Btech-project-2019/APFPOWVM/render/bottom.jpg

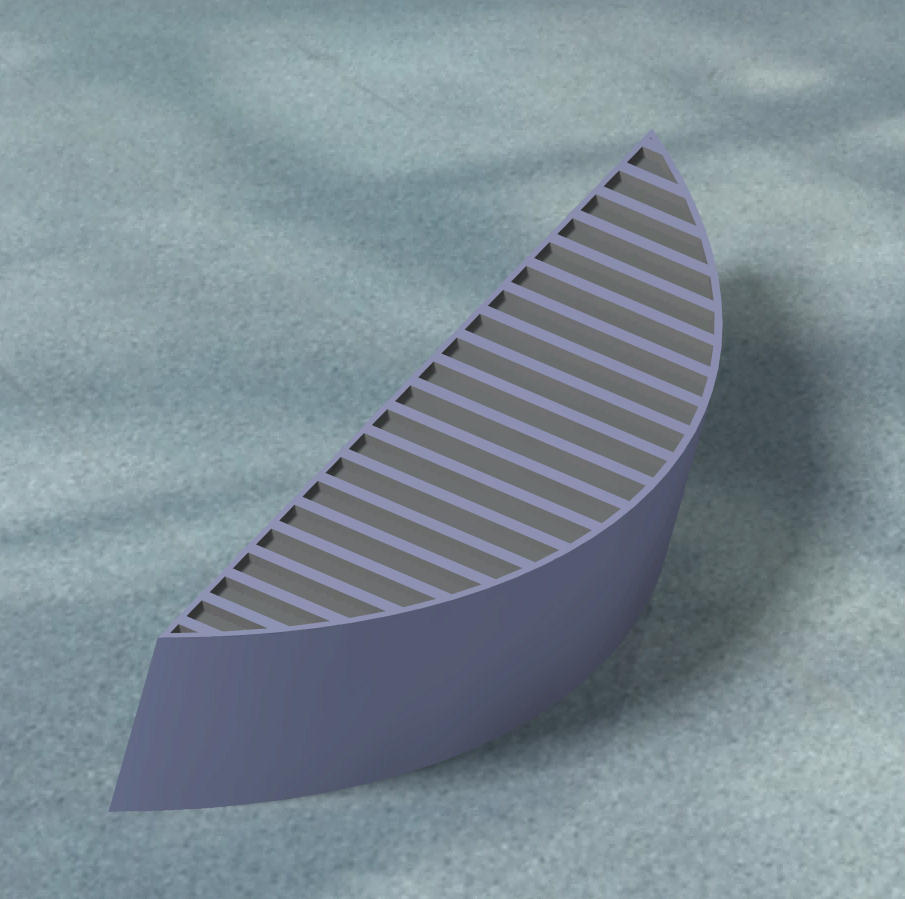
render/bottom.jpg
