Btech-project-2019/APFPOWVM/render/sevice door.jpg

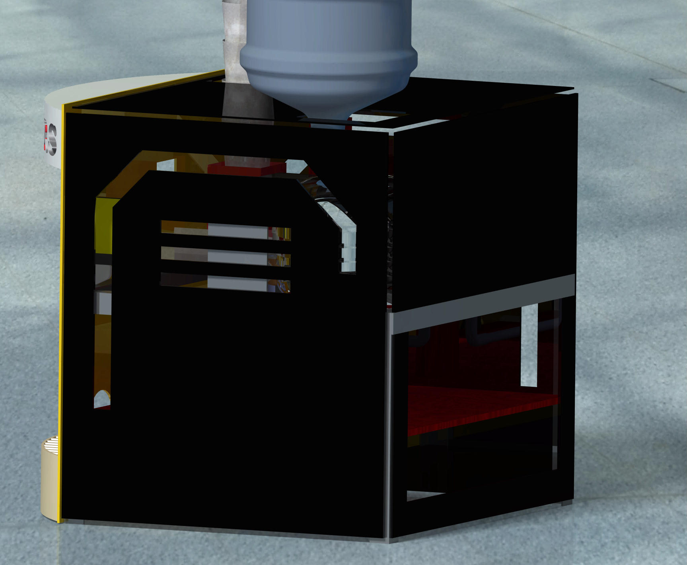
render/sevice door.jpg
