Btech-project-2019/APFPOWVM/README.md

# Automatic-paper-cup-fed-payment-operated-water-vending-machine
## [Project Report](https://github.com/btechproject2019/Automatic-paper-cup-fed-payment-operated-water-vending-machine/blob/master/pre%20project/Automatic%20vending%20Machine.pdf).
