Btech-project-2019/APFPOWVM/pre project/final presentation electronics.pptx

## Controlling System

- Flow chart:

## Slide 2

START

DISPLAY INSERT THE COIN ON LCD

COIN ACCEPTED

Dispense glass

Deciding type of water

START THE TAP FOR 10 sec

WATER DISPENSED

STOP

## Electronic Components

- Hardware:
1. Arduino Mega
2. Servo motors (10kgcm)
3. Relay for operating heater
4. WIFI Module for communication.

## Need for water level measurement

- The water level present In the smaller and larger container should be known so that flow rate of the water can be determined.
- This change in the flow rate will change the time required to fill the glass.

## Methods for measuring water level:

1. Counting amount of water dispensed.
2. Weight measurement.
3. Level Measurement.

## Counting amount of water dispensed.

- This is based on the assumption that initial volume of the water in both the containers is known.
- By knowing the water dispensed , The actual volume and head available can be found and hence the flow rate can be estimated.
- This method is completely theoretical, doesn’t need any instrumentation but depends mainly upon initial volume calculation accuracy.

## Weight measurement.

- This method includes measuring the weight of water present in the container by using load sensor and then from weight measuring the head, flow rate and then estimating time for filling the glass.
- This method requires an load cell for weight measurement but it is more accurate with easy to interpret results.

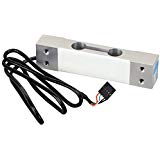
[picture p20: figure]

## Water level measurement

- Water level or head of water available can be easily found using an ultrasonic sensor.
- The ultrasonic sensor can be placed above the larger plastic container so that thickness of container comes in blind range of the sensor and it can give water level present in the container.
- But these results are subjected to error due to presence of the plastic wall in blind range of sensor.

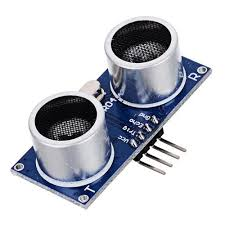
[picture p21: figure]

## Internet of things :

- The IOT is used for making the water dispenser smart.
- This is done by establishing the communication between water dispenser and another device connected to internet like a smartphone.
- By establishing the communication, these two devices can exchange information like water level, No of normal and hot water glasses dispensed in a day.

## IOT Block Diagram

Internet

Dispenser Controller

Smart
Phone

WiFi
ESP
8266
