Btech-project-2019/APFPOWVM/final internal.pptx

## Automatic Paper Glass Fed Liquid Dispensing Machine

Prateek Shamprasad Pawar 2015BME002
Prasad Shamrao Deshpande 2015BME016
Bhagwan Panditrao Savandkar 2015BME017
Niranjan Mohan Mane 2015BME032
Manthan Nitin Dhisale 2015BME051
Under the Guidance of
Prof. P.B.Chougule

## MANUFACTURING

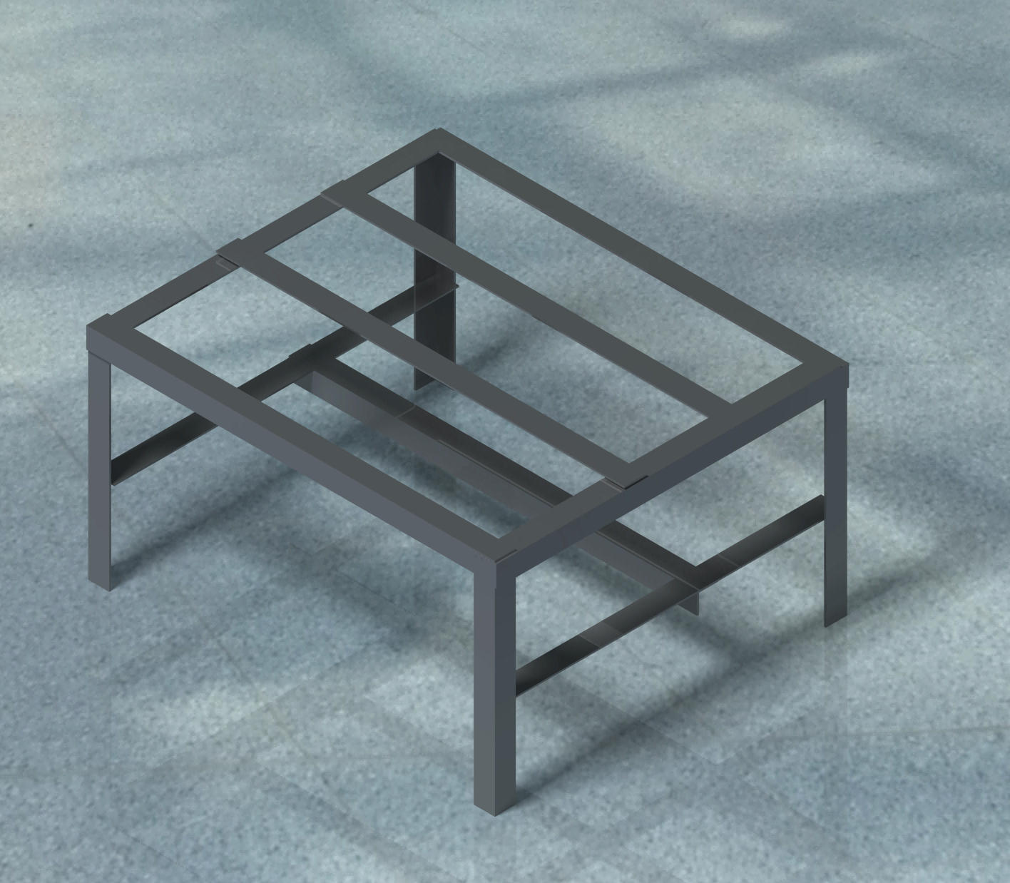
[picture p24: figure]
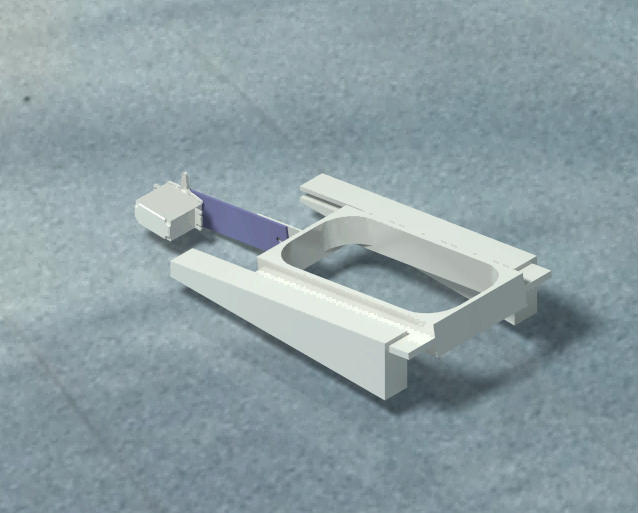
[picture p25: figure]
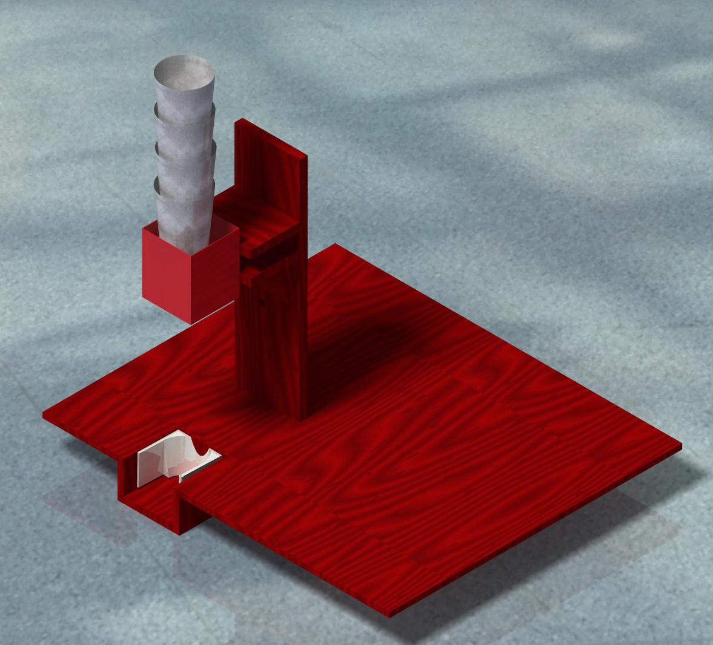
[picture p26: figure]
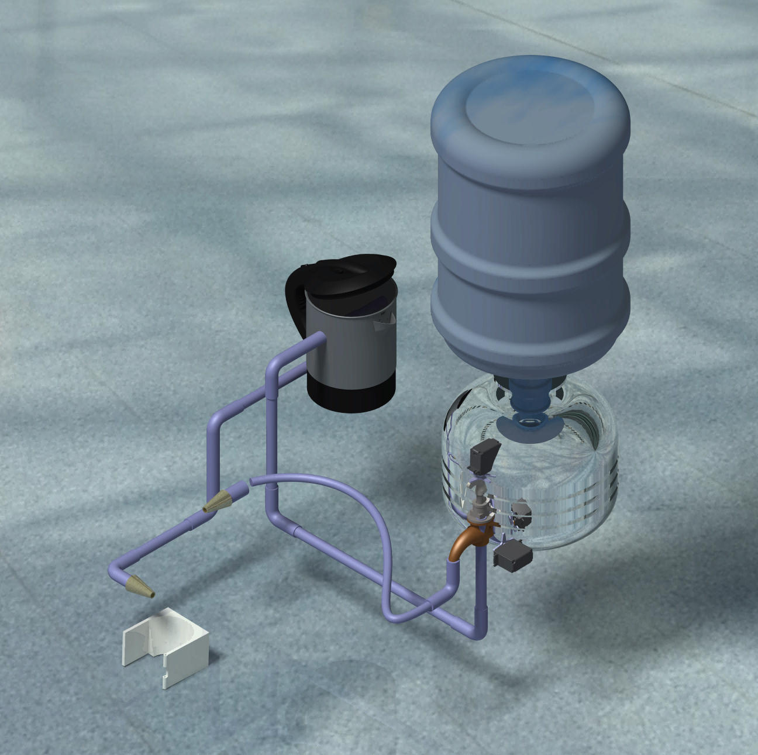
[picture p27: figure]
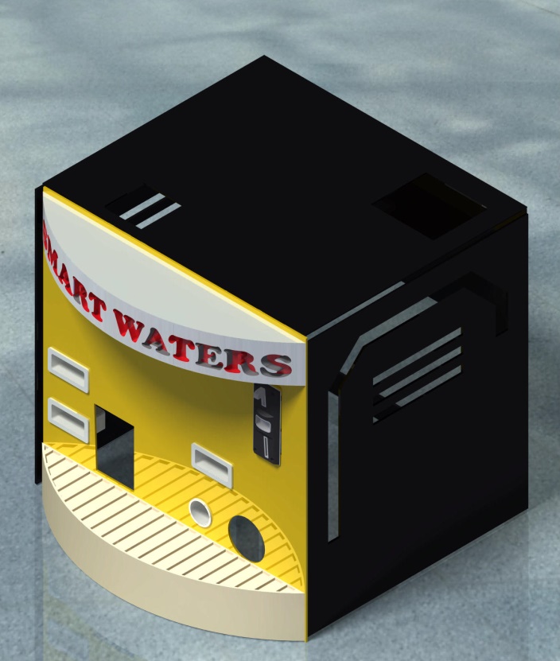
[picture p28: figure]

3. GLASS STACK

5. PANELS

4. WATER CKT

2. SLIDER & CUP CATCHER

1. TRUSS

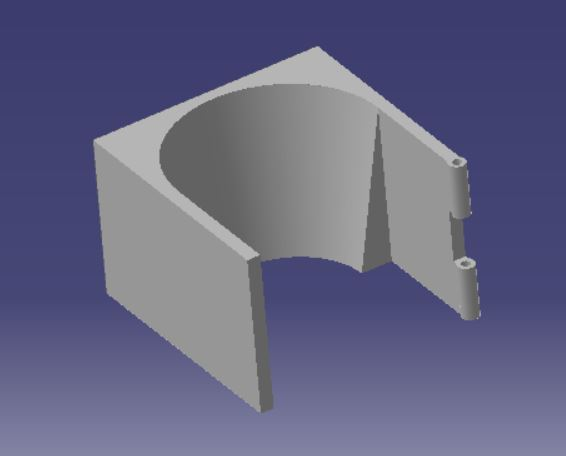
[picture p29: figure]

## PROCESS PLANNING

- Welding Truss
- Sheet Metal Forming Sink
- 3D Printing Cup Catcher and Slider Mechanism
- Bolting Panels and electronic components
- CNC Router Cutting Panels
- End Milling Heater Inlet and Outlet
- Radial Drilling and reaming Dispenser, Glass stack stand
- Adhesive Bonding Plumbing PVC pipes and Bibcocks
- Cutting, Grinding Truss, Cup guider, acrylic, etc
- Soldering Wires from wifi module, Arduino, Relay, SMPS etc to the supply

## DESIGN for SERVICING

Top Slider

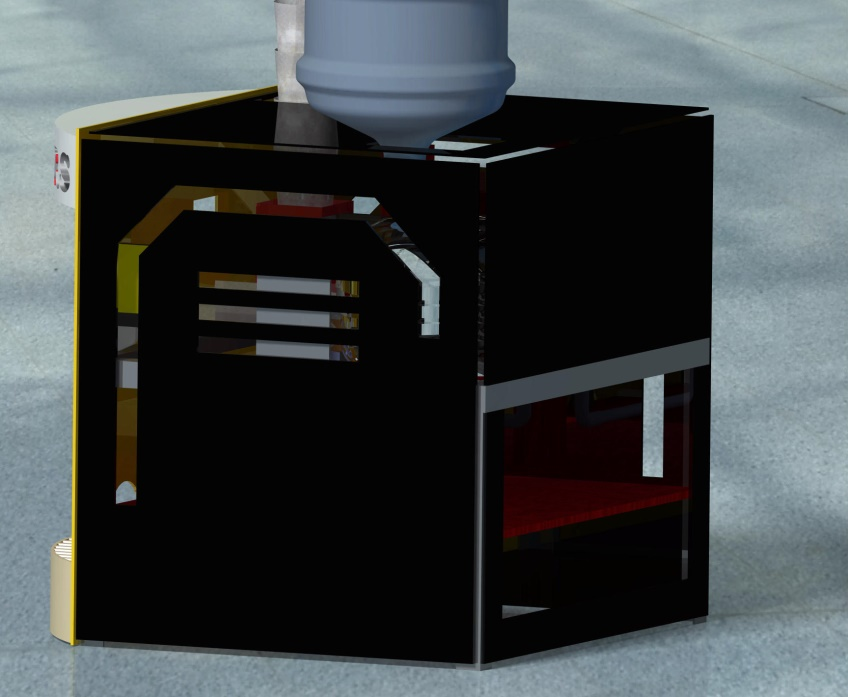
[picture p30: figure]

A. Back Door
1. Easy access to remove thrown glass
2. To collect coins entered
3. To access the electronic ckt

B. Top Slider
1. Easy access to critical parts such as coin detector
2. Water Bottle (Dispeneser) and Glass stack easy repair

Service Door
at back

## AESTHETIC

- Slots along with vents in Panels Consist of
Aluminium Composite Polymer (ACP) Sheets
- Arc Shaped Smart Waters
- Water Sink in shape of Rib

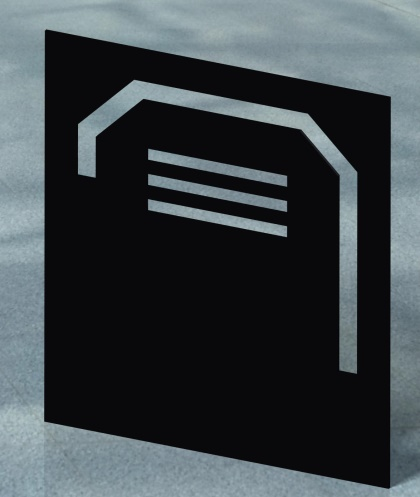
[picture p31: figure]
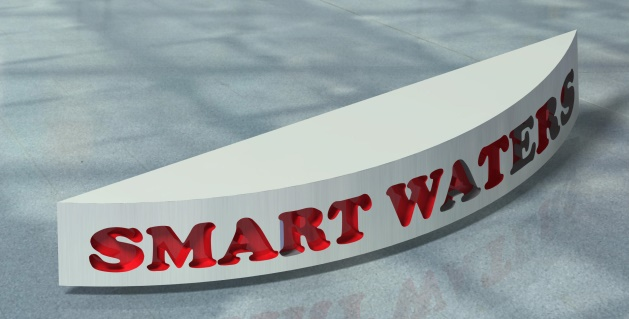
[picture p32: figure]
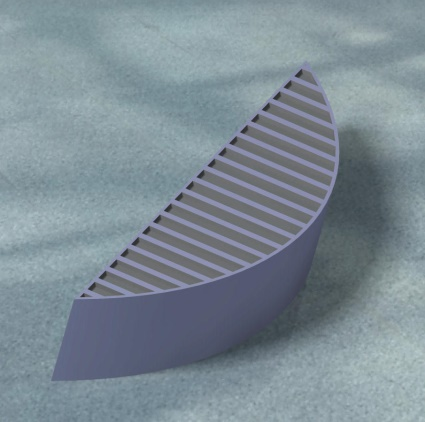
[picture p33: figure]

## ERGONOMICS

## FINANCE

## USP

## THANK YOU
