Btech-project-2019/APFPOWVM/pre project/water vending.pptx

## Payment Operated Automatic Paper Glass Fed Liquid Dispensing Machine

- Prateek Shamprasad Pawar(2015BME002)
- Prasad Shamrao Deshpande(2015BME016)
- Bhagwan Panditrao Savandkar(2015BME017)
- Niranjan Mohan Mane(2015BME032)
- Manthan Nitin Dhisale(2015BME051)

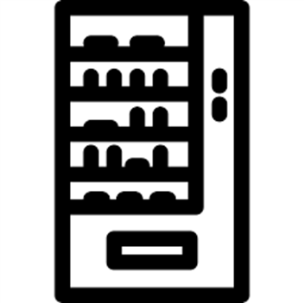
[picture p34: figure]
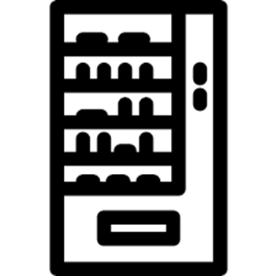
[picture p35: figure]
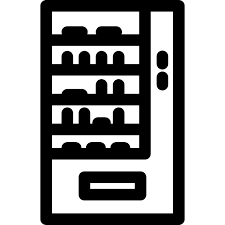
[picture p36: figure]
Image result for vending machine logo

## Planning

Forecasting
Setting Premises
Setting Objectives

## Forecasting

1. 70% of body is made of water

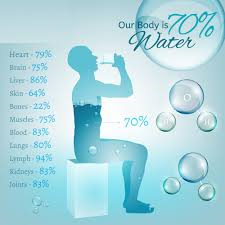
[picture p37: figure]

## Forecasting

2. Usage of water not optimal, wastage

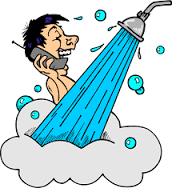
[picture p38: figure]

## Forecasting

3. Government of Maharashtra bans non-biodegradable plastics, threat to packaged drinking water

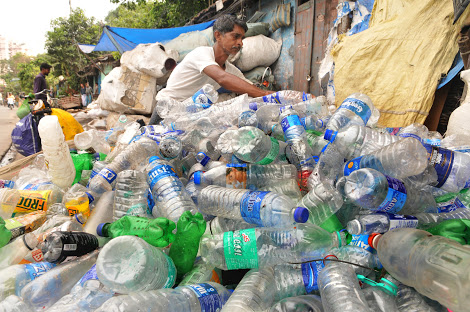
[picture p39: figure]

## Forecasting

4. Government launched Swatcha Jal Abhiyan

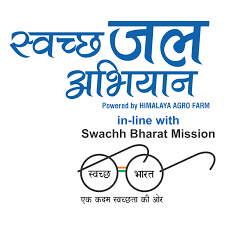
[picture p40: figure]

## Forecasting

5. Current water distribution system, too many intermediates, waste of money and time

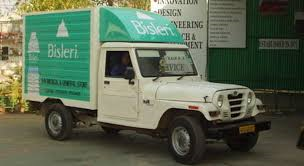
[picture p41: figure]

## Forecasting

6. iOT based SCM is growing need of time and era of vending machines (self pay and purchase) is about to begin.

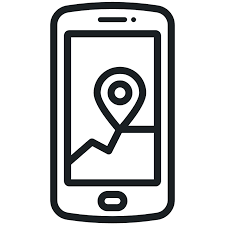
[picture p42: figure]
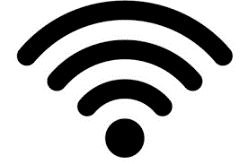
[picture p43: figure]

## Setting Premises

- Considering a rough model of our Sangli city and knowing stats about how much glasses of water will be required and how many visitors will be present, we came up with optimized setup.

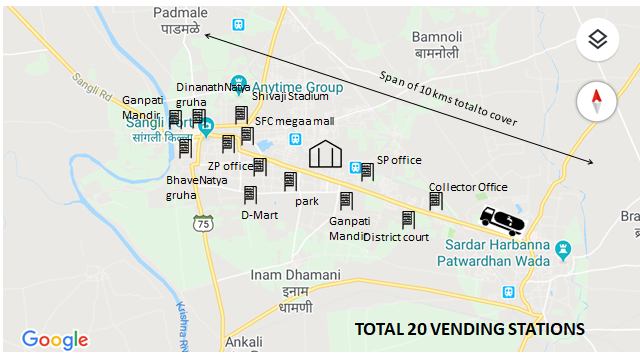
[picture p44: figure]

## Visions and objectives

1. To study different mechanical and electronic principles involved in the automation project.
2. To select appropriate sensors and actuators for constructing various mechanisms involved in the automation project. 3.
3. To manufacture a complete workable and commercial model by following aesthetic and ergonomic principles.
4. To implement Information of technology principles for exchange of information from the dispenser to the user.
5. To execute a proper algorithm-based program for Arduino controlled sensors and actuators for the intended application.
6. To include liquid monitoring features so as to control and provide proper dispensing of liquid to the customer.

## Implementation

- The implementation of the project plan is an important step because the accuracy of plan made for project is depending upon actual time taken for activity.

## Slide 12

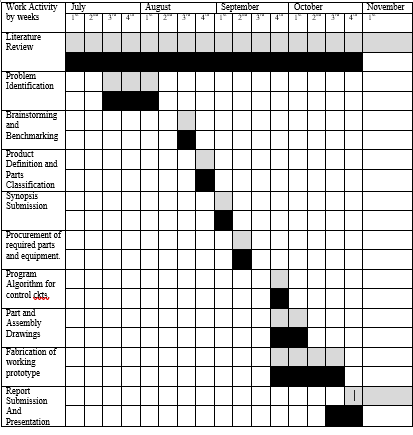
[picture p45: figure]
