Btech-project-2019/APFPOWVM/flow chart.pdf

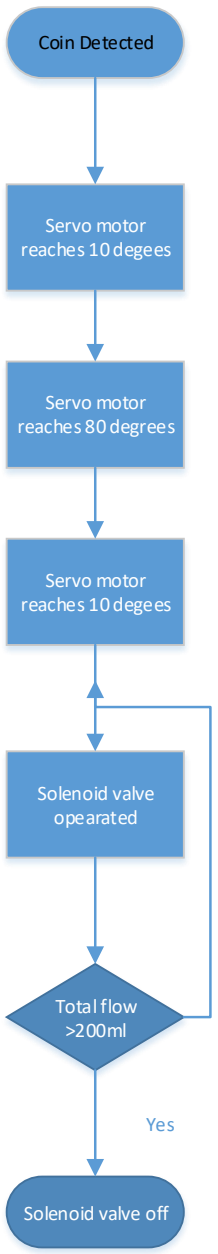
[picture p46: figure]
Coin Detected; Servo motor reaches 10 degees; Servo motor reaches 80 degrees; Solenoid valve opearated; Total flow >200ml; Solenoid valve off; Yes

NO
