Btech-project-2019/APFPOWVM/report/introduction.docx

History Of Vending Machine-

"Vending" or "automatic retailing" or Dispensing Machine as the process of selling merchandise via automated machine is increasingly known, has a long history. The first recorded example of a vending machine comes from the Greek mathematician Hero of Alexandria, who invented a device that dispensed holy water inside Egyptian temples.

Other early examples include small machines made of brass that dispensed tobacco, which were found in some taverns in England around 1615. In 1822, an English publisher owner named Richard Carlile built a newspaper dispensing machine that allowed patrons to purchase banned works. And it was in 1867 that the first fully automatic vending machine, which dispensed stamps, appeared.

### Coin-Operated Vending Machines

During the early 1880s, the first commercial coin-operated vending machines were introduced in London, England. Invented in 1883 by Percival Everitt, the machines were found at railway stations and post offices, as they were a convenient way to purchase envelopes, postcards, and notepaper. And in 1887, the first vending machine servicer, the Sweetmeat Automatic Delivery Company, was founded.

In 1888, the Thomas Adams Gum Company introduced the very first vending machines to the United States. The machines were installed on the elevated subway platforms in New York City and sold Tutti-Fruiti gum. In 1897, the Pulver Manufacturing Company added animated figures to its gum machines as an added attraction. The round, candy-coated gumball (https://www.thoughtco.com/history-of-bubble-and-chewing-gum-1991856) and gumball vending machines were introduced in 1907.

### Coin-Operated Restaurants

Soon, vending machines were available that offered almost everything, including cigars, postcards, and stamps. In Philadelphia, a completely coin-operated automat (https://www.thoughtco.com/the-rise-and-fall-of-the-automat-4152992) restaurant called Horn & Hardart was opened in 1902 and stayed opened until 1962. Such fast-food restaurants, called automats, only took nickels and were popular among struggling songwriters and actors, as well as celebrities of that era.

### Beverage Vending Machines

Machines that dispensed drinks go as far back as 1890. The very first beverage vending machine was located in Paris, France and allowed people to buy beer wine and liquor. In the early 1920s, the first automatic vending machines started dispensing sodas (https://www.thoughtco.com/introduction-to-soda-pop-1992433) into cups. Today, beverages are among the most popular items sold through vending machines.

### Cigarettes in Vending Machines

In 1926, an American inventor named William Rowe invented the cigarette (https://www.thoughtco.com/who-invented-electronic-cigarettes-1991598) vending machine. Over time, however, they became increasingly less common in the United States due to concerns over underage buyers. In other countries, vendors have addressed the issue by requiring that some sort of age verification, such as a driver's license, bank card or ID be inserted before a purchase can be made. Cigarette dispensing machines are still common in Germany, Austria, Italy, the Czech Republic, and Japan.

### Specialty Vending Machines

Food, beverages, and cigarettes are the most common items sold in vending machines, but the list of specialty items sold by this form of automation is almost endless, as a quick survey of any airport or bus terminal will tell you. The vending machine industry took a big jump around 2006, when credit card scanners started to become common on vending machines. Within ten years, almost every new vending machine was equipped to accept credit cards. This opened the door to the sale of many high-priced items through vending machines. Here are just some of the specialty products that have been offered via vending machine:

- Fishing bait
- On-line internet time
- Lottery tickets
- Books
- Electronics, including I-pads, cell phones, digital cameras, and computers.
- Hot foods, such as french fries and pizza
- Life insurance
- Condoms and other contraceptives
- Over-the-counter drugs
- Marijuana
- Automobiles

Yes, you read that last item correctly. In late 2016, Autobahn Motors in Singapore opened a luxury car vending machine that offered Ferrari and Lamborghini cars. Buyers clearly need hefty limits on their credit cards.

### Japan, Land of the Vending Machines

Japan has gained a reputation for having some of the most innovative use of vending machines, offering machines that offer products including fresh fruits and vegetables, sake, hot foods, batteries, flowers, clothing and, of course, sushi. In fact, Japan has the highest per capita rate of vending machines in the world.

Popularity in Japan-

Vending machines are a common sight in Japan. There are more than 5.5 million throughout the nation. It is the highest ratio for any country with one machine for every twenty-three people.

## Smart vending machines

Similar to the development of traditional mobile phones (https://en.wikipedia.org/wiki/Mobile_phones) into smartphones (https://en.wikipedia.org/wiki/Smartphones), vending machines have also progressively, though at a much slower pace, evolved into smart vending machines. Newer technologies at a lower cost of adoption, such as the large digital touch display (https://en.wikipedia.org/wiki/Touchscreen), internet connectivity, cameras and various types of sensors, more cost-effective embedded computing (https://en.wikipedia.org/wiki/Embedded_computing) power, digital signage (https://en.wikipedia.org/wiki/Digital_signage), various advanced payment systems, and a wide range of identification technology (NFC (https://en.wikipedia.org/wiki/Near_field_communication), RFID (https://en.wikipedia.org/wiki/Radio-frequency_identification), etc) have contributed to this development. These smart vending machines enable a more interactive user experience, and reduce operating costs while improving the efficiency of the vending operations through remote manageability and intelligent back-end analytic (https://en.wikipedia.org/wiki/Analytics). Integrated sensors and cameras also represent a source of such data as customer demographics, purchase trends, and other locality-specific information. It also enables better customer-engagement for the brands through interactive multimedia and social media connectivity. Smart vending machines were #79 by JWT Intelligence on its list of 100 Things to Watch in 2014. According to market research by Frost & Sullivan, global shipments of smart vending machines are forecasted to reach around 2 million units by 2018, and further to 3.6 million units by 2020 with penetration rate of 20.3 percent.

Need for water dispensing unit in Indian Scenario-

In hot sunny day or in general while moving on roads, doing rigorous exercise, anywhere the thing required by everyone is water to quench thirst. Low Water level in the body leads to dehydration and which is very lethal to the life.

Ensuring clean drinking water from a trusted water source such as an RO water purifier or water filtered through RO + UV technique or water stored from above sources is what the time demands and one cannot compromise in its purity. So the proposed project will serve as a platform for payment based paper glass fed water dispensing machine, which will be storing safe and clean water from government facilities or commercial pure water suppliers.

With a vending machine, we need not to hire an employee for serving water. Neither we have to be present all the day and in night also it will provide service, as a machine it will be free from fatigue which is the behaviour of normal employee. All we need to do is to stock of water, Paper glass and electricity source for the machine and it’s done. It has features that allows the customer to purchase and pay without being assisted by anyone.

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

This is a product which will be the connecting link between government organisations and individuals or NGOs or companies to have such water distribution system which will aid in public welfare. Even companies can install such machines leading to reduced supply chain costs incurred presently and also to reduce overall cost as product is directly supplied to the end user. Even this system can be utilized for other beverages by proper changes.

This is the age of technology and ours is a sincere effort to develop an environment friendly affordable water vending facility.
