Btech-project-2019/APFPOWVM/flow_sensor/I2C-LCD-Module-Board-Arduino-Mega-2560.jpg

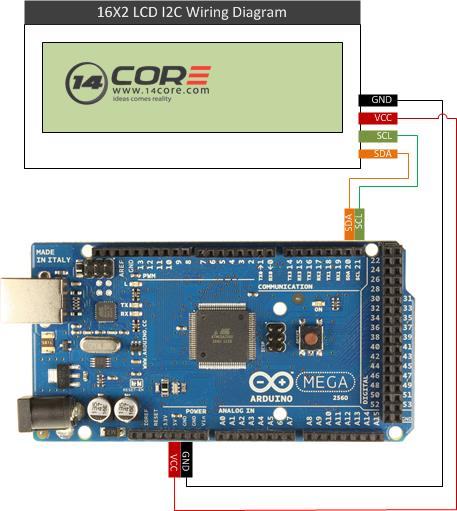
flow_sensor/I2C-LCD-Module-Board-Arduino-Mega-2560.jpg
