Btech-project-2019/APFPOWVM/pcb desigh/pcb.png

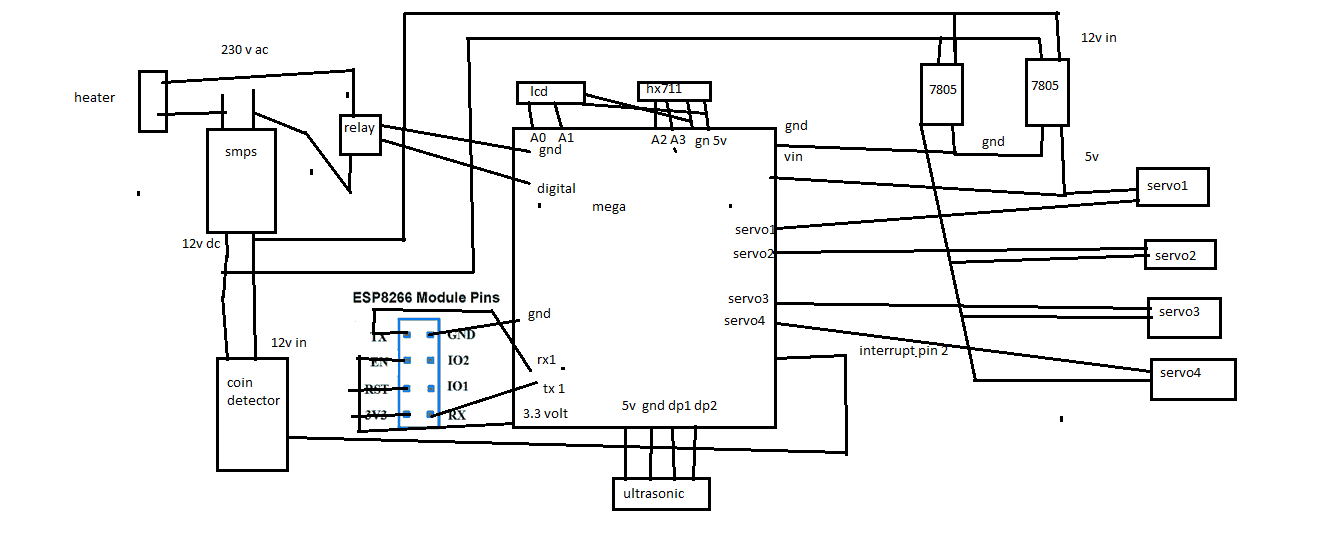
pcb desigh/pcb.png
