Btech-project-2019/APFPOWVM/project presentation/arduino.jpg

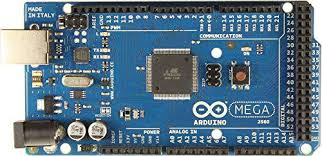
project presentation/arduino.jpg
