Btech-project-2019/APFPOWVM/project presentation/esp.jpg

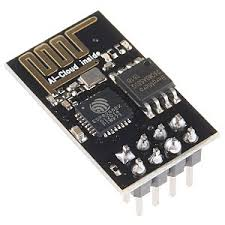
project presentation/esp.jpg
