Btech-project-2019/APFPOWVM/project presentation/telegram.jpg

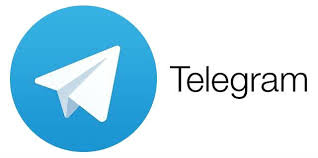
project presentation/telegram.jpg
