Btech-project-2019/APFPOWVM/project presentation/water height.bmp

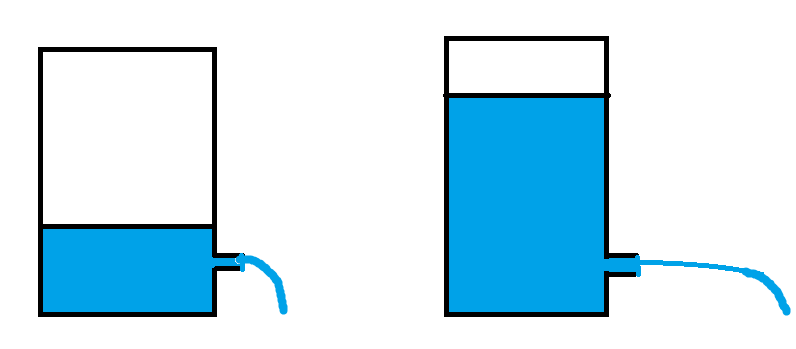
project presentation/water height.bmp
