Btech-project-2019/APFPOWVM/single-wall-cold-drink-cup-dimensions-pp.png

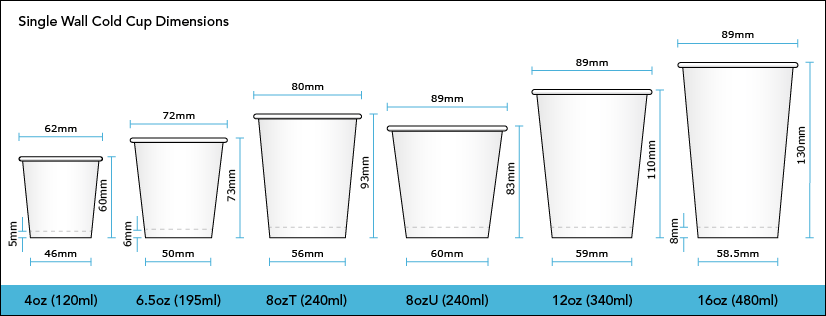
single-wall-cold-drink-cup-dimensions-pp.png
