Btech-project-2019/APFPOWVM/telegram/wifitoarduino_jz26ak1QwK.jpg

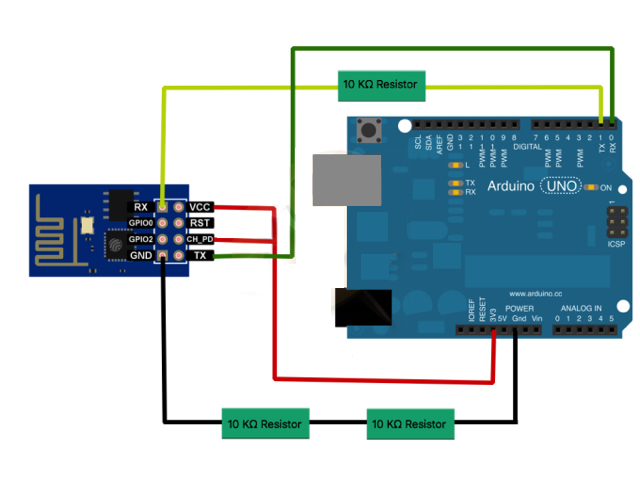
telegram/wifitoarduino_jz26ak1QwK.jpg
