Btech-project-2019/APFPOWVM/assembly final iges/cup catcher v5.SLDASM

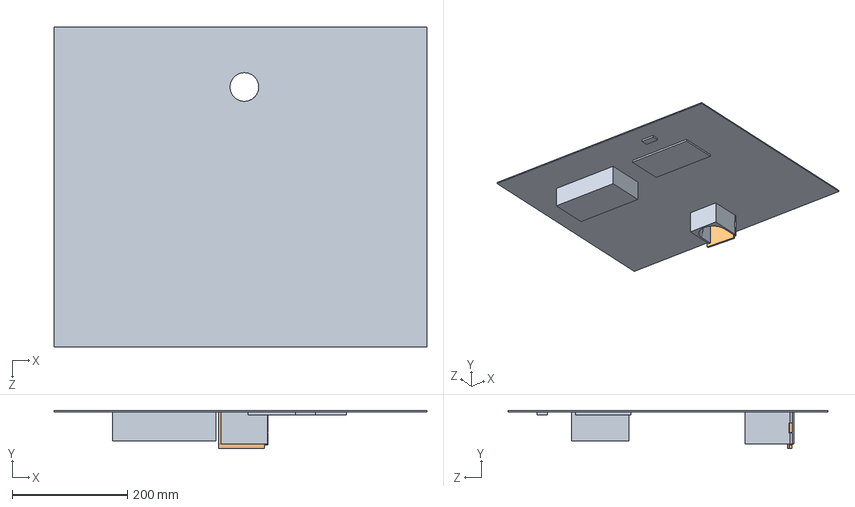
[picture p55: CAD file, 2020-05-20]
assembly final iges/cup catcher v5.SLDASM
648.4 x 66.3 x 556.5 mm
cup catcher v5
