Btech-project-2019/APFPOWVM/assembly.SLDASM

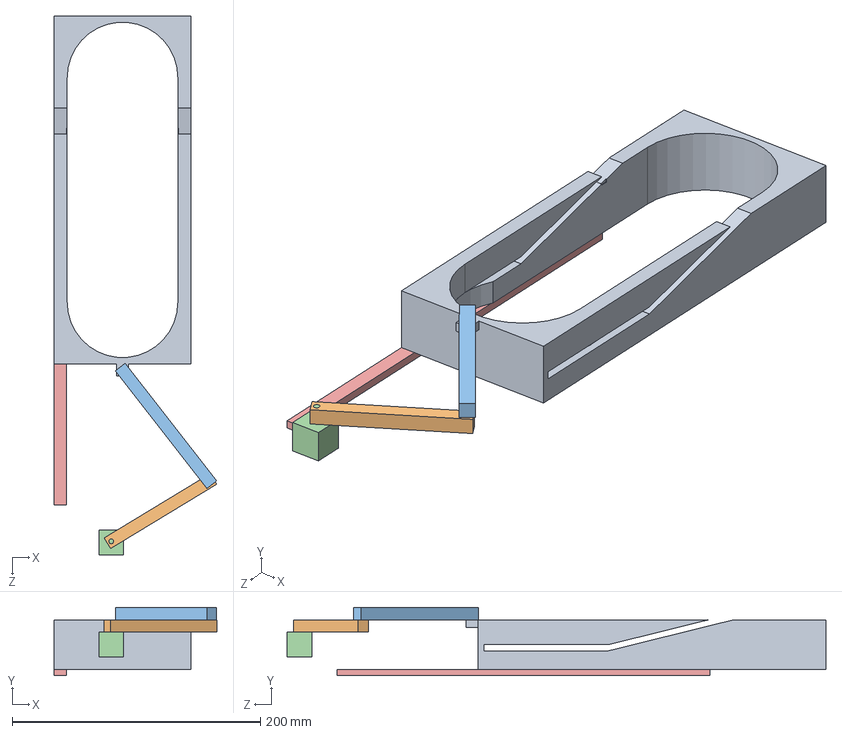
[picture p56: CAD file, 2020-05-20]
assembly.SLDASM
130.9 x 55.0 x 433.9 mm
cup separator
link 2
link1
motor
slide
