Btech-project-2019/APFPOWVM/assembly final iges/Assem1.SLDASM

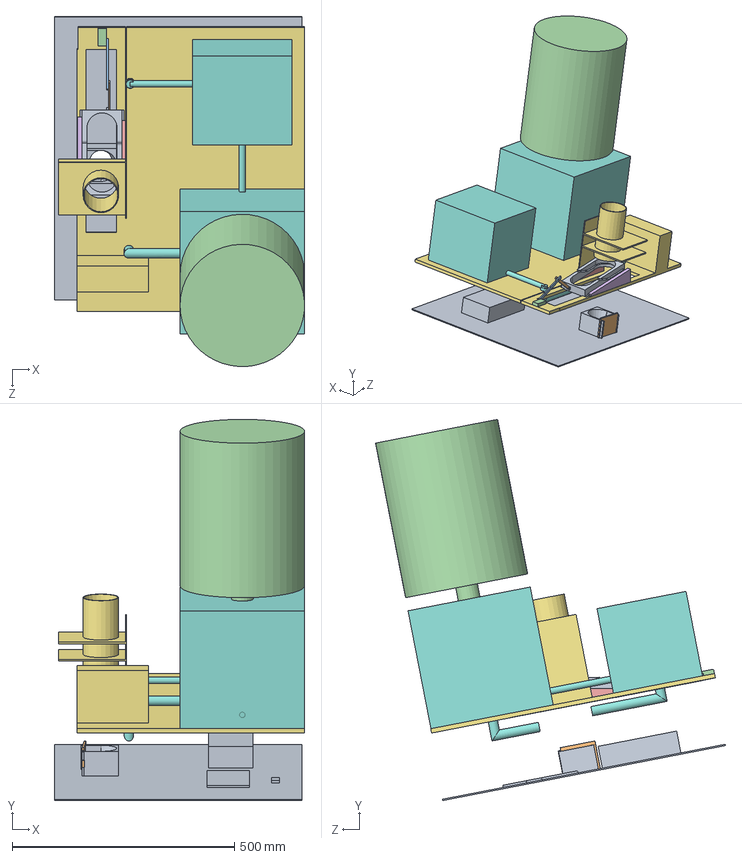
[picture p57: CAD file, 2020-05-20]
assembly final iges/Assem1.SLDASM
562.5 x 857.2 x 787.0 mm
cup separator 2
link1
link2
motor
slider1
slider2
base1
container1
cup catcher v5
container2
