Btech-project-2019/APFPOWVM/cup separator 2 section.SLDPRT

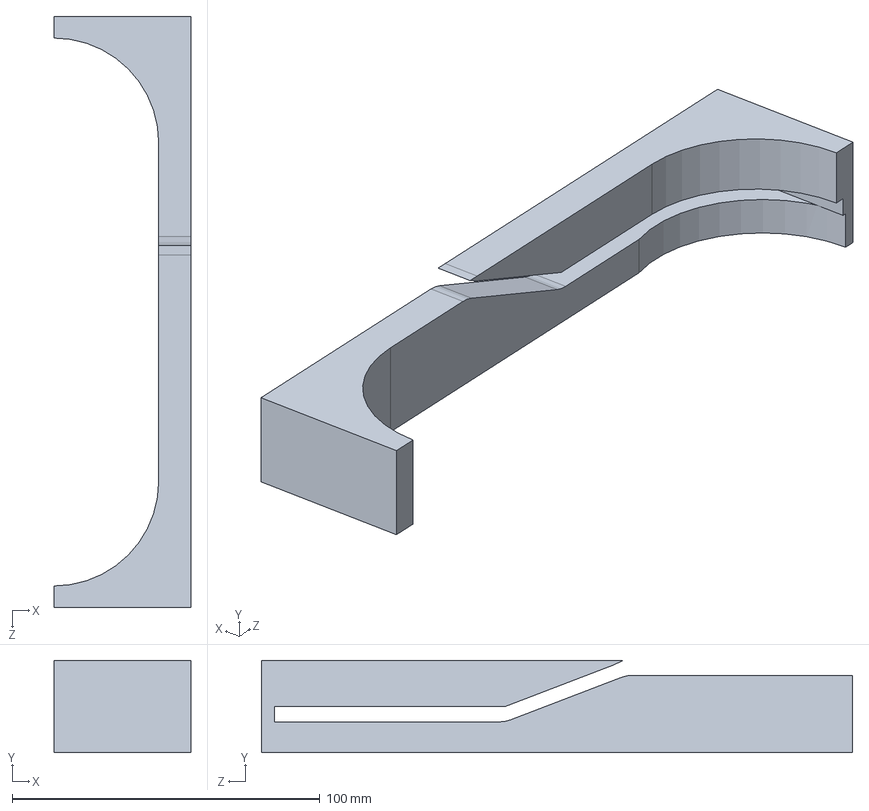
[picture p58: CAD file, 2020-05-20]
cup separator 2 section.SLDPRT
44.5 x 30.0 x 192.0 mm
