Btech-project-2019/APFPOWVM/link 2.SLDPRT

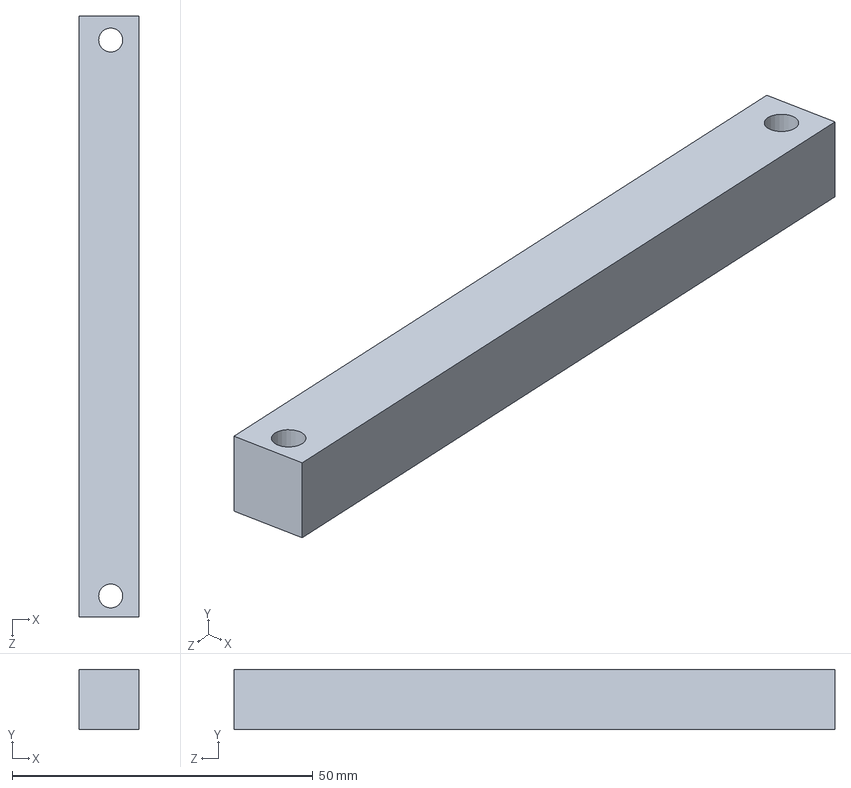
[picture p59: CAD file, 2020-05-20]
link 2.SLDPRT
10.0 x 10.0 x 100.0 mm
