Btech-project-2019/APFPOWVM/assembly final iges/slider2.SLDPRT

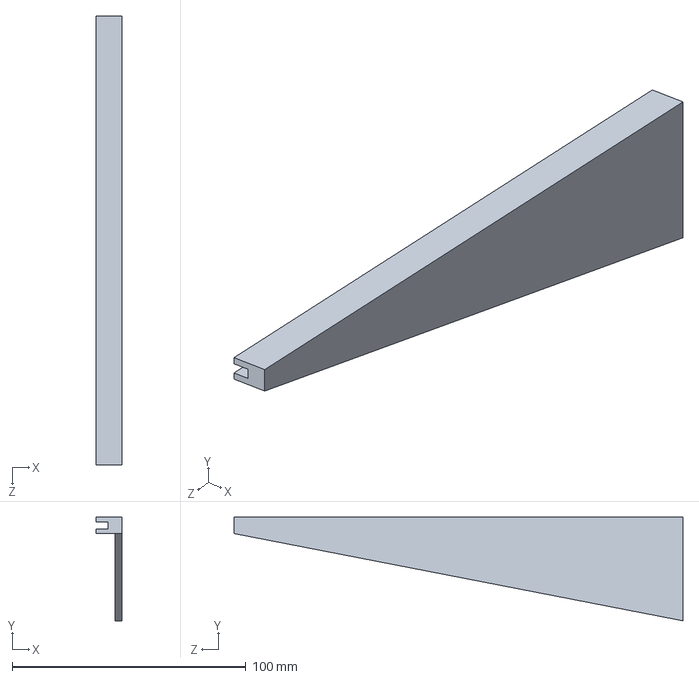
[picture p60: CAD file, 2020-05-20]
assembly final iges/slider2.SLDPRT
11.0 x 44.3 x 192.0 mm
