Btech-project-2019/APFPOWVM/assembly final iges/base1.SLDPRT

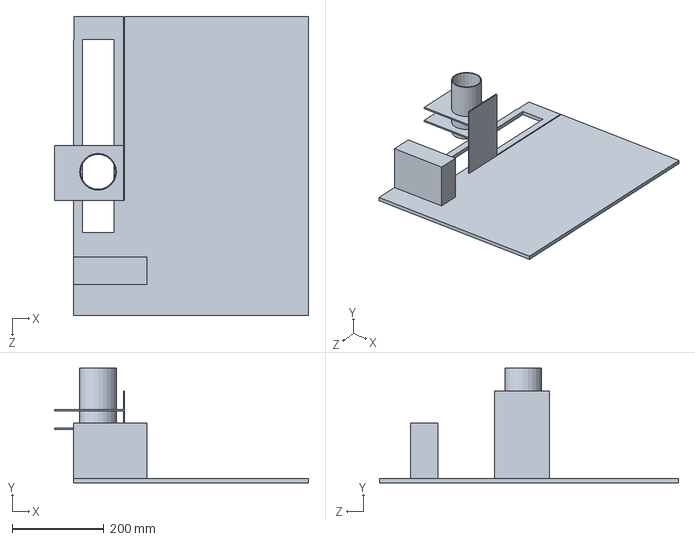
[picture p61: CAD file, 2020-05-20]
assembly final iges/base1.SLDPRT
553.0 x 250.0 x 650.3 mm
