Btech-project-2019/APFPOWVM/cup separator.SLDPRT

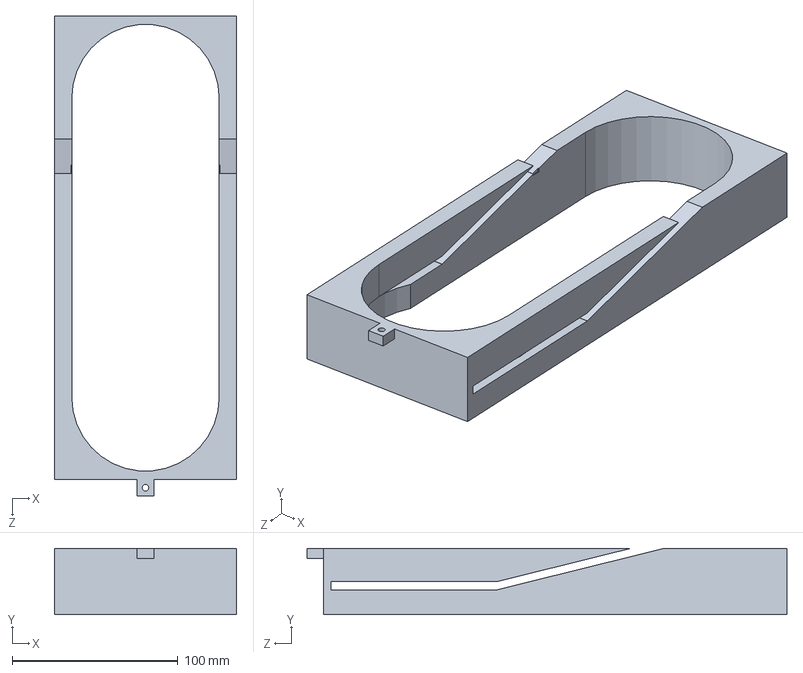
[picture p62: CAD file, 2020-05-20]
cup separator.SLDPRT
110.0 x 40.0 x 290.0 mm
