Btech-project-2019/APFPOWVM/acralic plate.SLDPRT

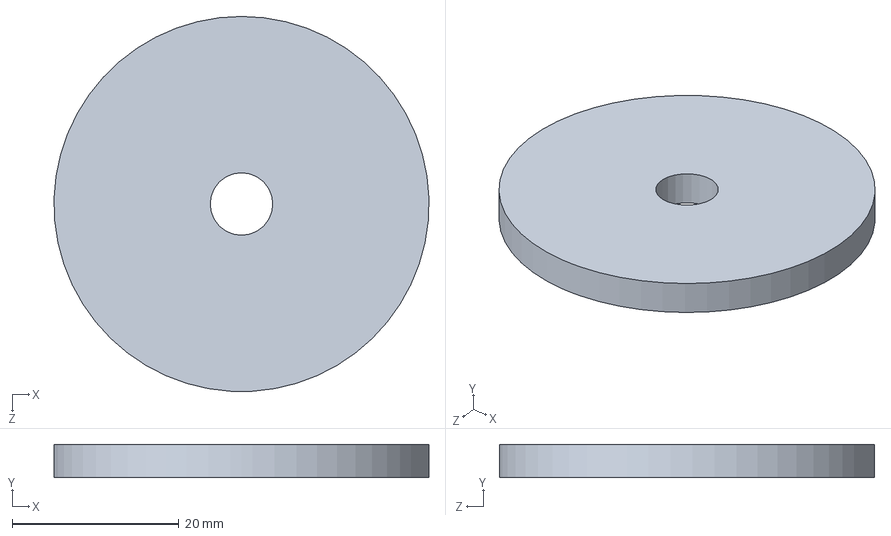
[picture p63: CAD file, 2020-05-20]
acralic plate.SLDPRT
45.0 x 4.00 x 45.0 mm
