Btech-project-2019/APFPOWVM/assembly final iges/container1.SLDPRT

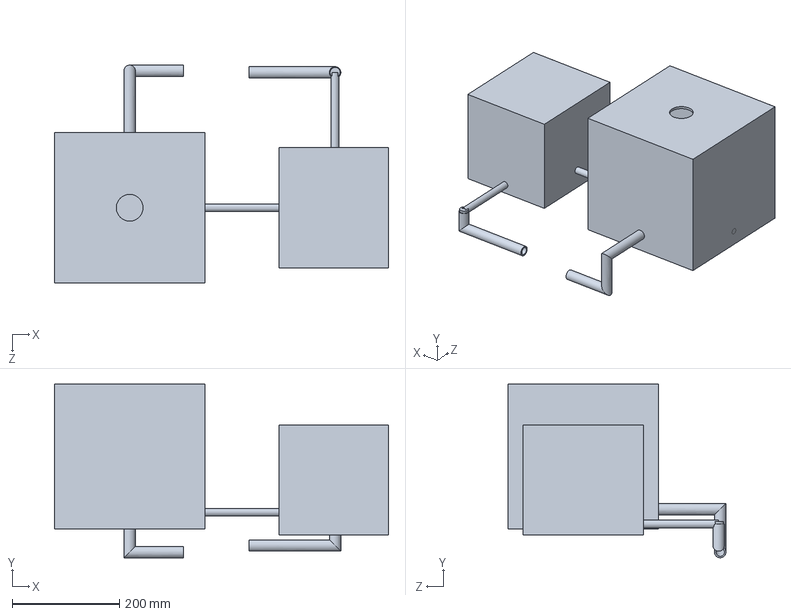
[picture p64: CAD file, 2020-05-20]
assembly final iges/container1.SLDPRT
622.0 x 323.4 x 405.7 mm
