Btech-project-2019/APFPOWVM/assembly final iges/cup separator 2.SLDPRT

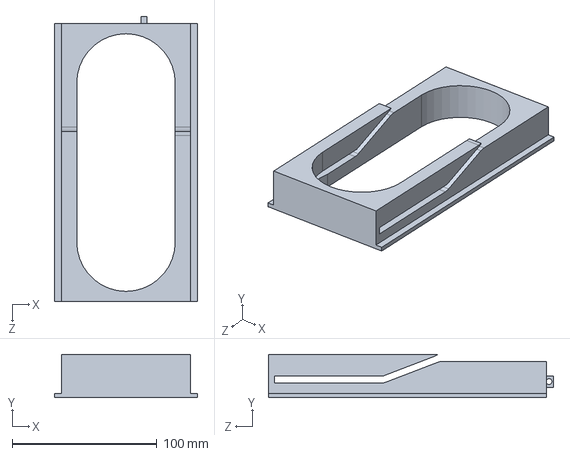
[picture p65: CAD file, 2020-05-20]
assembly final iges/cup separator 2.SLDPRT
99.0 x 30.0 x 196.9 mm
