Btech-project-2019/APFPOWVM/motor.SLDPRT

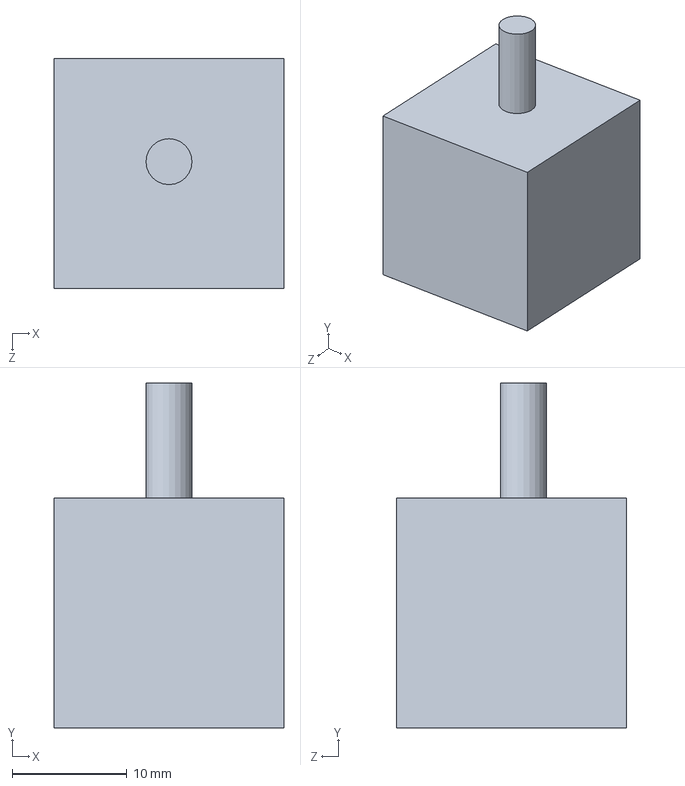
[picture p66: CAD file, 2020-05-20]
motor.SLDPRT
20.0 x 30.0 x 20.0 mm
