Btech-project-2019/APFPOWVM/slide.SLDPRT

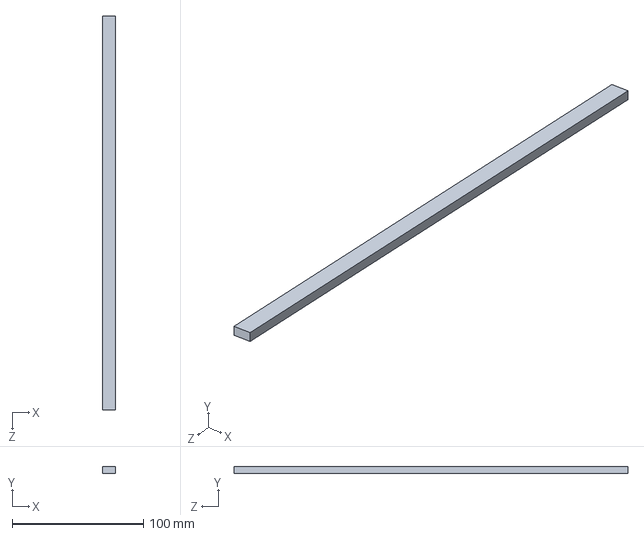
[picture p67: CAD file, 2020-05-20]
slide.SLDPRT
9.99 x 5.00 x 300.0 mm
