Btech-project-2019/APFPOWVM/assembly final iges/link1.SLDPRT

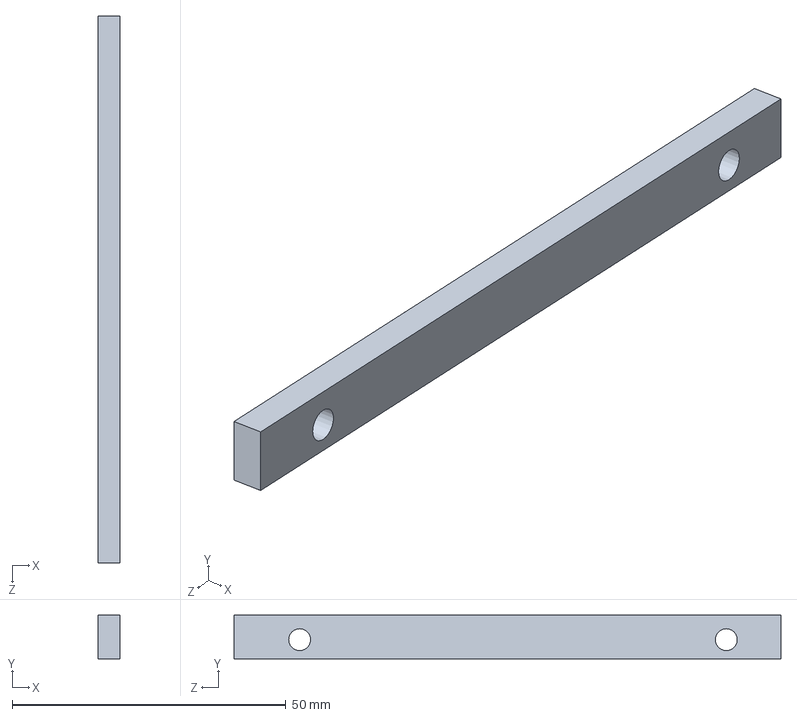
[picture p68: CAD file, 2020-05-20]
assembly final iges/link1.SLDPRT
4.00 x 8.00 x 100.0 mm
