Btech-project-2019/APFPOWVM/link1.SLDPRT

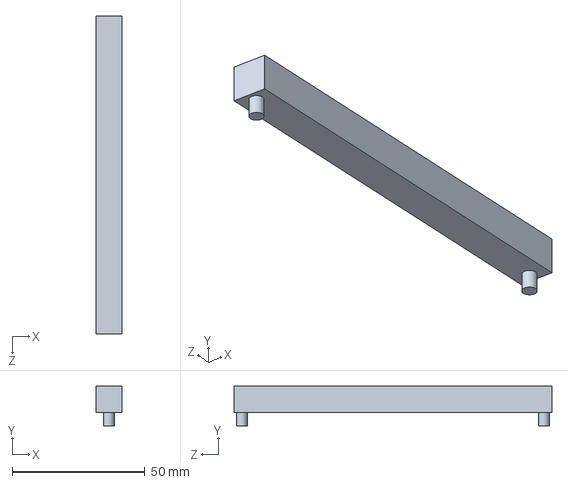
[picture p69: CAD file, 2020-05-20]
link1.SLDPRT
10.0 x 15.0 x 120.0 mm
