Btech-project-2019/APFPOWVM/assembly final iges/motor.SLDPRT

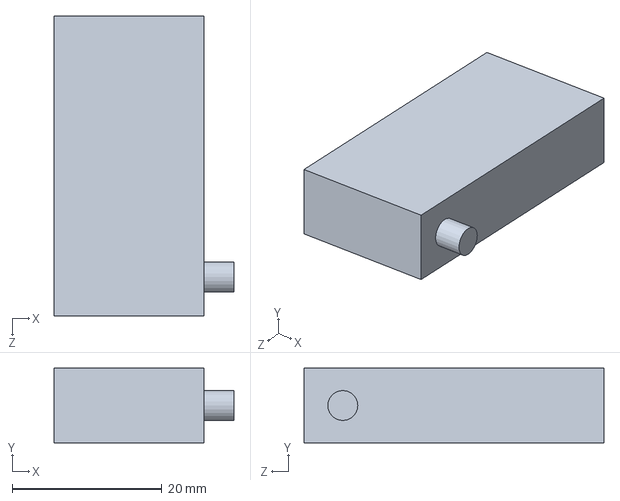
[picture p70: CAD file, 2020-05-20]
assembly final iges/motor.SLDPRT
24.0 x 10.0 x 40.0 mm
