Btech-project-2019/APFPOWVM/cup separator 2.SLDPRT

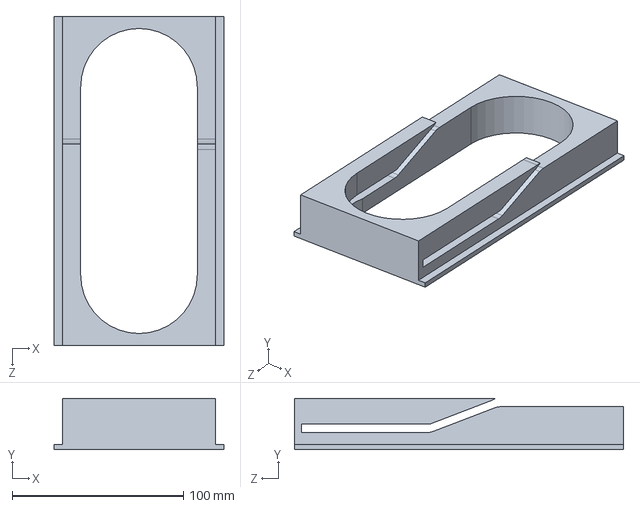
[picture p71: CAD file, 2020-05-20]
cup separator 2.SLDPRT
99.0 x 30.0 x 192.0 mm
