Btech-project-2019/APFPOWVM/assembly final iges/link2.SLDPRT

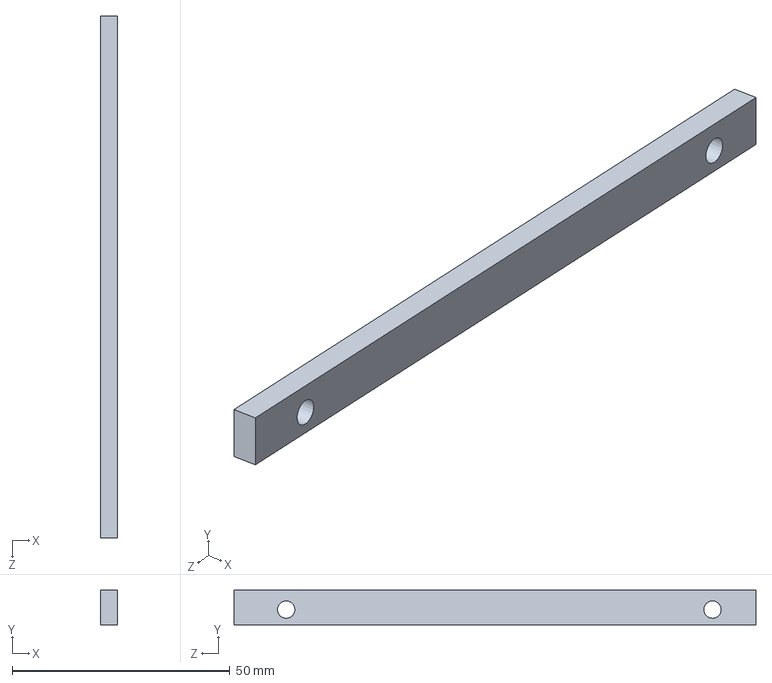
[picture p72: CAD file, 2020-05-20]
assembly final iges/link2.SLDPRT
4.00 x 8.00 x 120.0 mm
