Btech-project-2019/APFPOWVM/assembly final iges/container2.SLDPRT

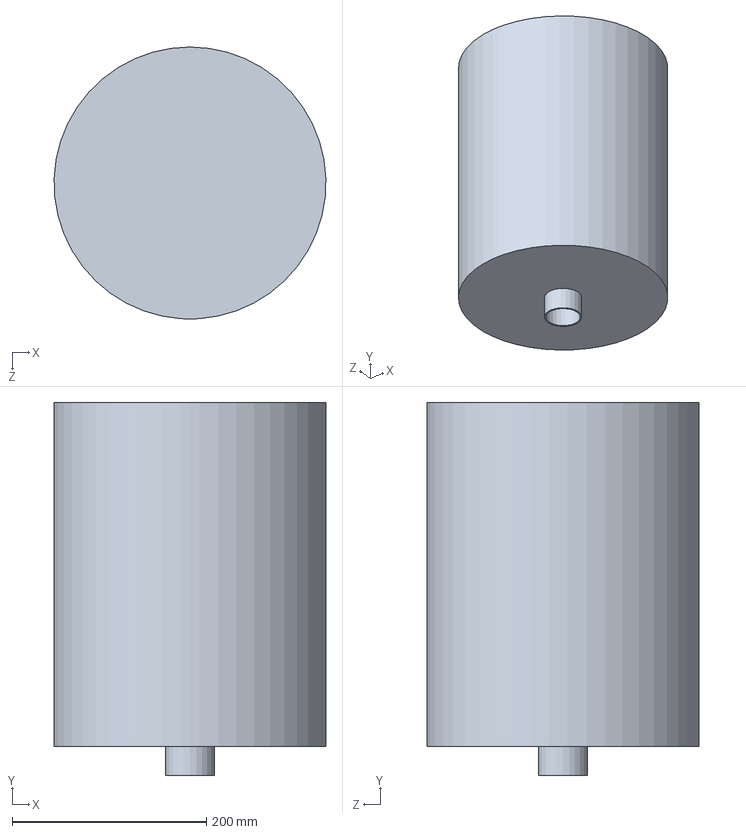
[picture p73: CAD file, 2020-05-20]
assembly final iges/container2.SLDPRT
279.8 x 384.0 x 280.0 mm
