Btech-project-2019/APFPOWVM/assembly final iges/slider1.SLDPRT

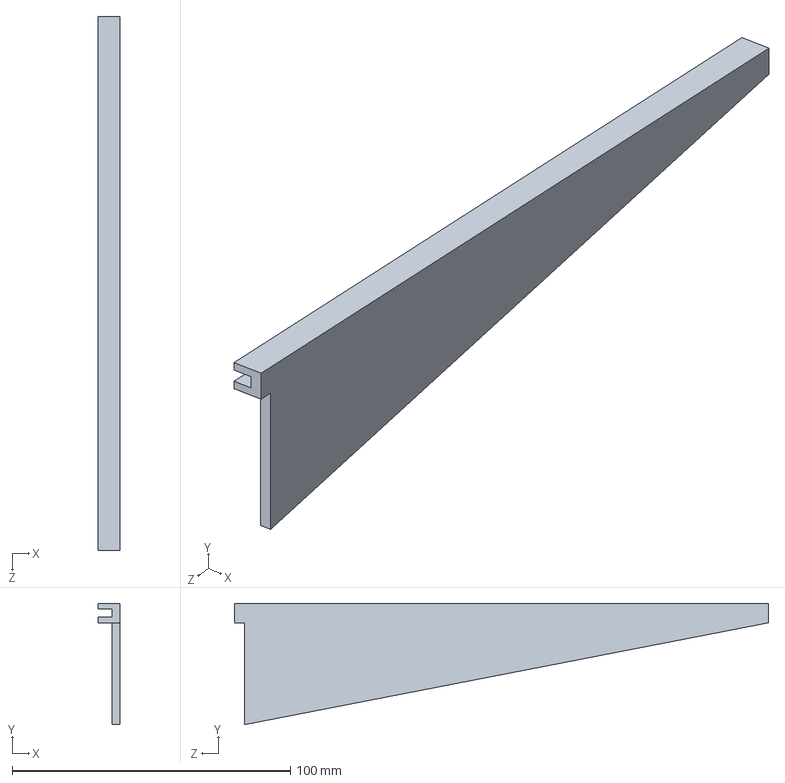
[picture p74: CAD file, 2020-05-20]
assembly final iges/slider1.SLDPRT
8.00 x 43.6 x 192.0 mm
