Btech-project-2019/APFPOWVM/(list of files, cad)

Other CAD files:
assembly final iges/Component2.sldprt
1111.SLDPRT
assembly final iges/Component3.sldprt
acralic plate.STL
assembly final iges/cup catcher v5.IGS
assembly final iges/cup catcher v5.sldprt
assembly final/Component2.sldprt
assembly final/Component3.sldprt
assembly final/cup catcher v5.SLDASM
assembly final/cup catcher v5.sldprt
cup separator 2 section.IGS
cup separator 2 section.STL
