Btech-project-2019/APFPOWVM/assembly.JPG

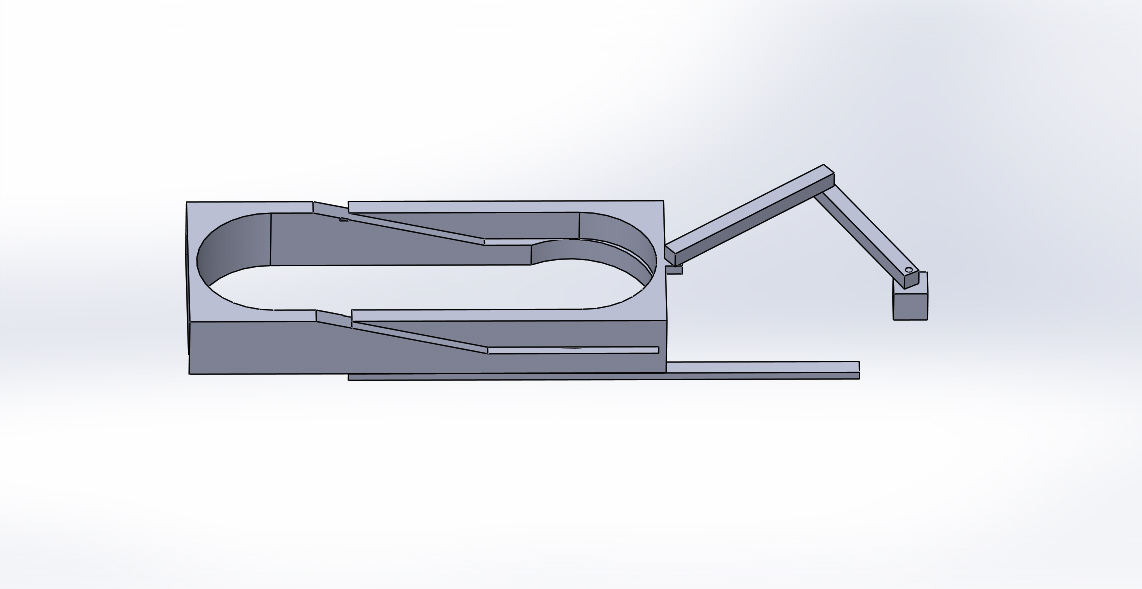
assembly.JPG
