Btech-project-2019/APFPOWVM/flow chart final.pdf

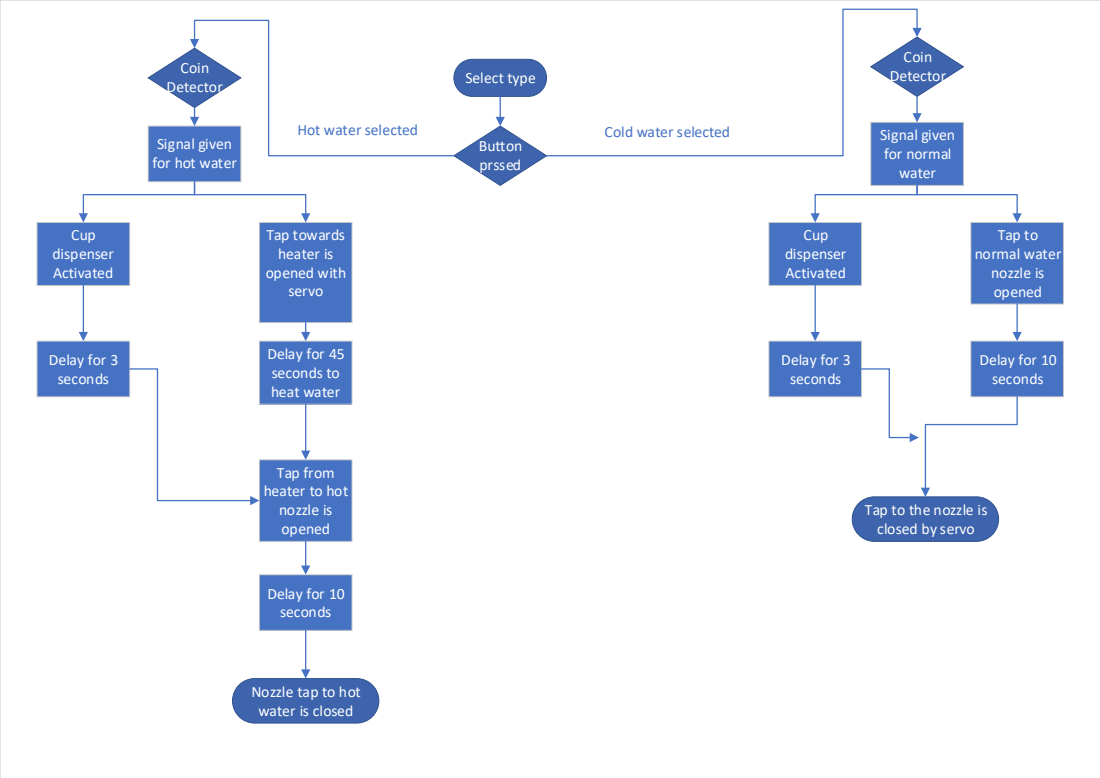
[picture p77: page 1]
Select type; Button prssed; Signal given for normal water; Cup dispenser Activated; Tap towards heater is opened with servo; Tap to normal water nozzle is opened; Delay for 10 seconds; Delay for 3 seconds; Delay for 45 seconds to heat water; Hot water selected; Cold water selected; Coin Detector

Signal given
for hot water

Tap from
heater to hot
nozzle is
opened

Tap to the nozzle is
closed by servo

Nozzle tap to hot
water is closed
