Btech-project-2019/APFPOWVM/flow chart new.pdf

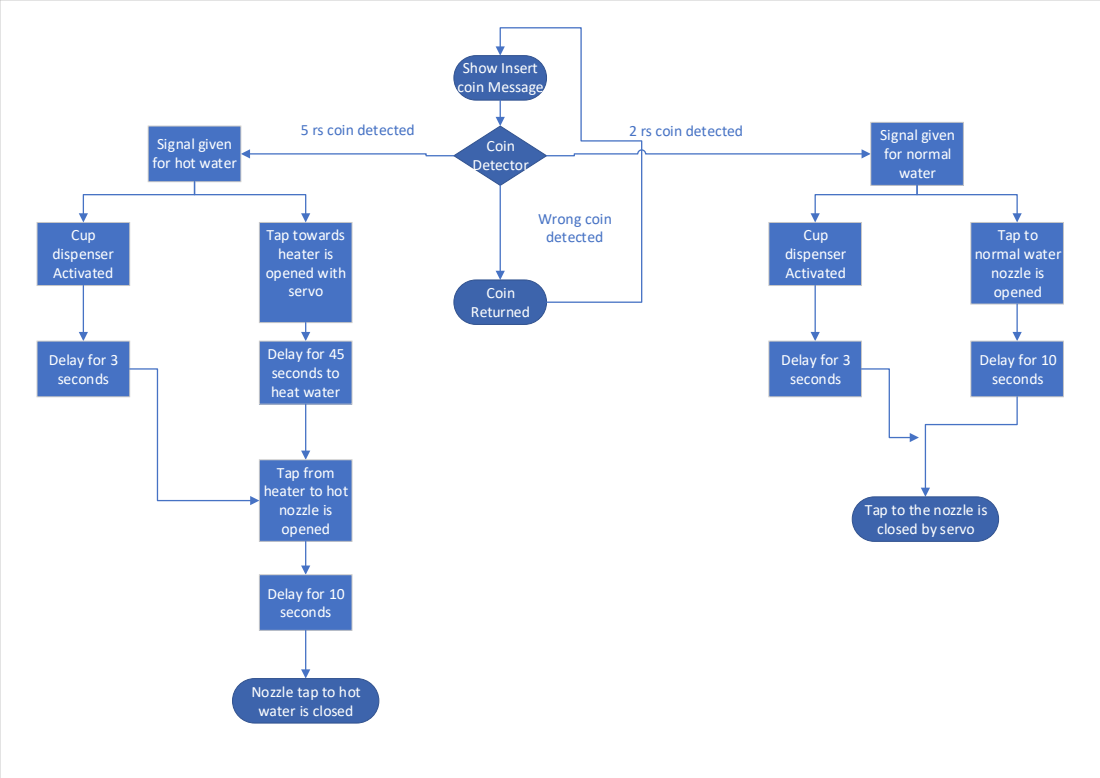
[picture p78: page 1]
Show Insert coin Message; Coin Detector; Coin Returned; Signal given for normal water; Cup dispenser Activated; Tap towards heater is opened with servo; Tap to normal water nozzle is opened; Delay for 10 seconds; Delay for 3 seconds; Delay for 45 seconds to heat water; 5 rs coin detected; 2 rs coin detected; Wrong coin detected

Signal given
for hot water

Tap from
heater to hot
nozzle is
opened

Tap to the nozzle is
closed by servo

Nozzle tap to hot
water is closed
