Btech-project-2019/APFPOWVM/tele_final/tele_final.ino

/*
 Name:        echoBot.ino
 Created:     12/21/2017
 Author:      Stefano Ledda <shurillu@tiscalinet.it>
 Description: a simple example that check for incoming messages
              and reply the sender with the received message
*/
#include "CTBot.h"
CTBot myBot;

String ssid  = "Moto Z2 Play 9800"    ; // REPLACE mySSID WITH YOUR WIFI SSID
String pass  = ""; // REPLACE myPassword YOUR WIFI PASSWORD, IF ANY
String token = "705123203:AAH-xT_iITGfWbd2IgfIiSbDZXon2k_bErU"   ; // REPLACE myToken WITH YOUR TELEGRAM BOT TOKEN

void setup() {
  // initialize the Serial
  Serial1.begin(115200);
  Serial1.println("Starting TelegramBot...");

  // connect the ESP8266 to the desired access point
  myBot.wifiConnect(ssid, pass);

  // set the telegram bot token
  myBot.setTelegramToken(token);
  
  // check if all things are ok
  if (myBot.testConnection())
    Serial1.println("\ntestConnection OK");
  else
    Serial1.println("\ntestConnection NOK");
}

void loop() {
  // a variable to store telegram message data
  TBMessage msg;

  // if there is an incoming message...
  if (myBot.getNewMessage(msg))
    // ...forward it to the sender
    myBot.sendMessage(msg.sender.id, msg.text);
   
  // wait 500 milliseconds
  delay(500);
}
