Btech-project-2019/APFPOWVM/flow_sensor/lcd_hello/lcd_hello.ino

//YWROBOT
//Compatible with the Arduino IDE 1.0
//Library version:1.1
#include <Wire.h> 
#include <LiquidCrystal_I2C.h>

LiquidCrystal_I2C lcd(0x3F,16,2);  // set the LCD address to 0x27 for a 16 chars and 2 line display

void setup()
{
                      // initialize the lcd 
  
  // Print a message to the LCD.
  lcd.backlight();
  lcd.setCursor(0,0);
  lcd.print("Hello, world!");
 
}


void loop()
{
}
